MDRRC/Rc5ToXPressnet/Doc/pcb.JPG

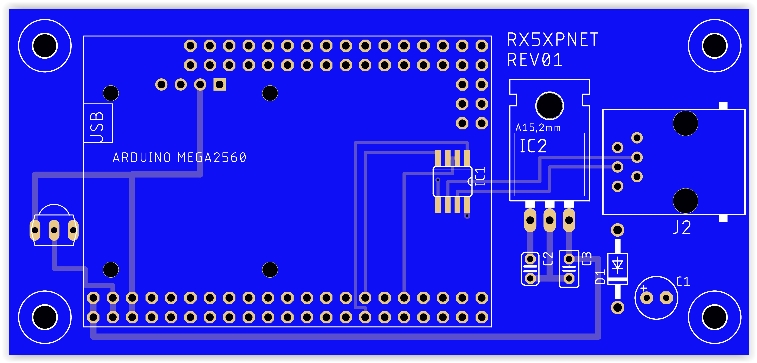
Doc/pcb.JPG
