MDRRC/Rc5ToXPressnet/Doc/rx5xpressnetcomponents.pdf

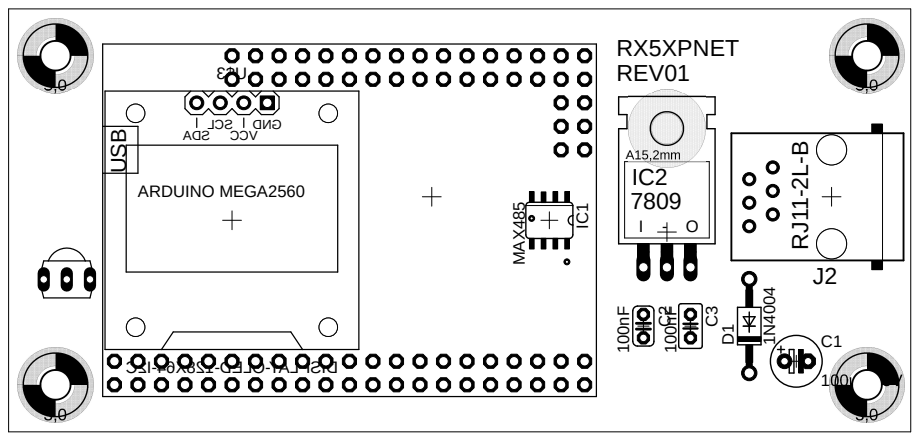
[picture p9: page 1]
ARDUINO MEGA2560 USB; RX5XPNET; REV01; C1 IC¹; 100uF/25V ¹N⁴⁰⁰⁴ MAX⁴⁸⁵
