MDRRC/Rc5ToXPressnet/Doc/rx5xpressnetschematic.pdf

D47 | D47 D46 | D46 D45 | D45 D44 | D44 D43 | D43 D42 | D42 D41 | D41 D40 | D40 D39 | D39 D38 | D38 D37 | D37 D36 | D36 D35 | D35 D34 | D34 D33 | D33 D32 | D32 A15 | A15 A14 | A14 A13 | A13 A12 | A12 A11 | A11 A10 | A10 A9 | A9 A8 | A8 A7 | A7 A6 | A6 A5 | A5 A4 | A4 A3 | A3 A2 | A2 A1 | A1 A0 | A0

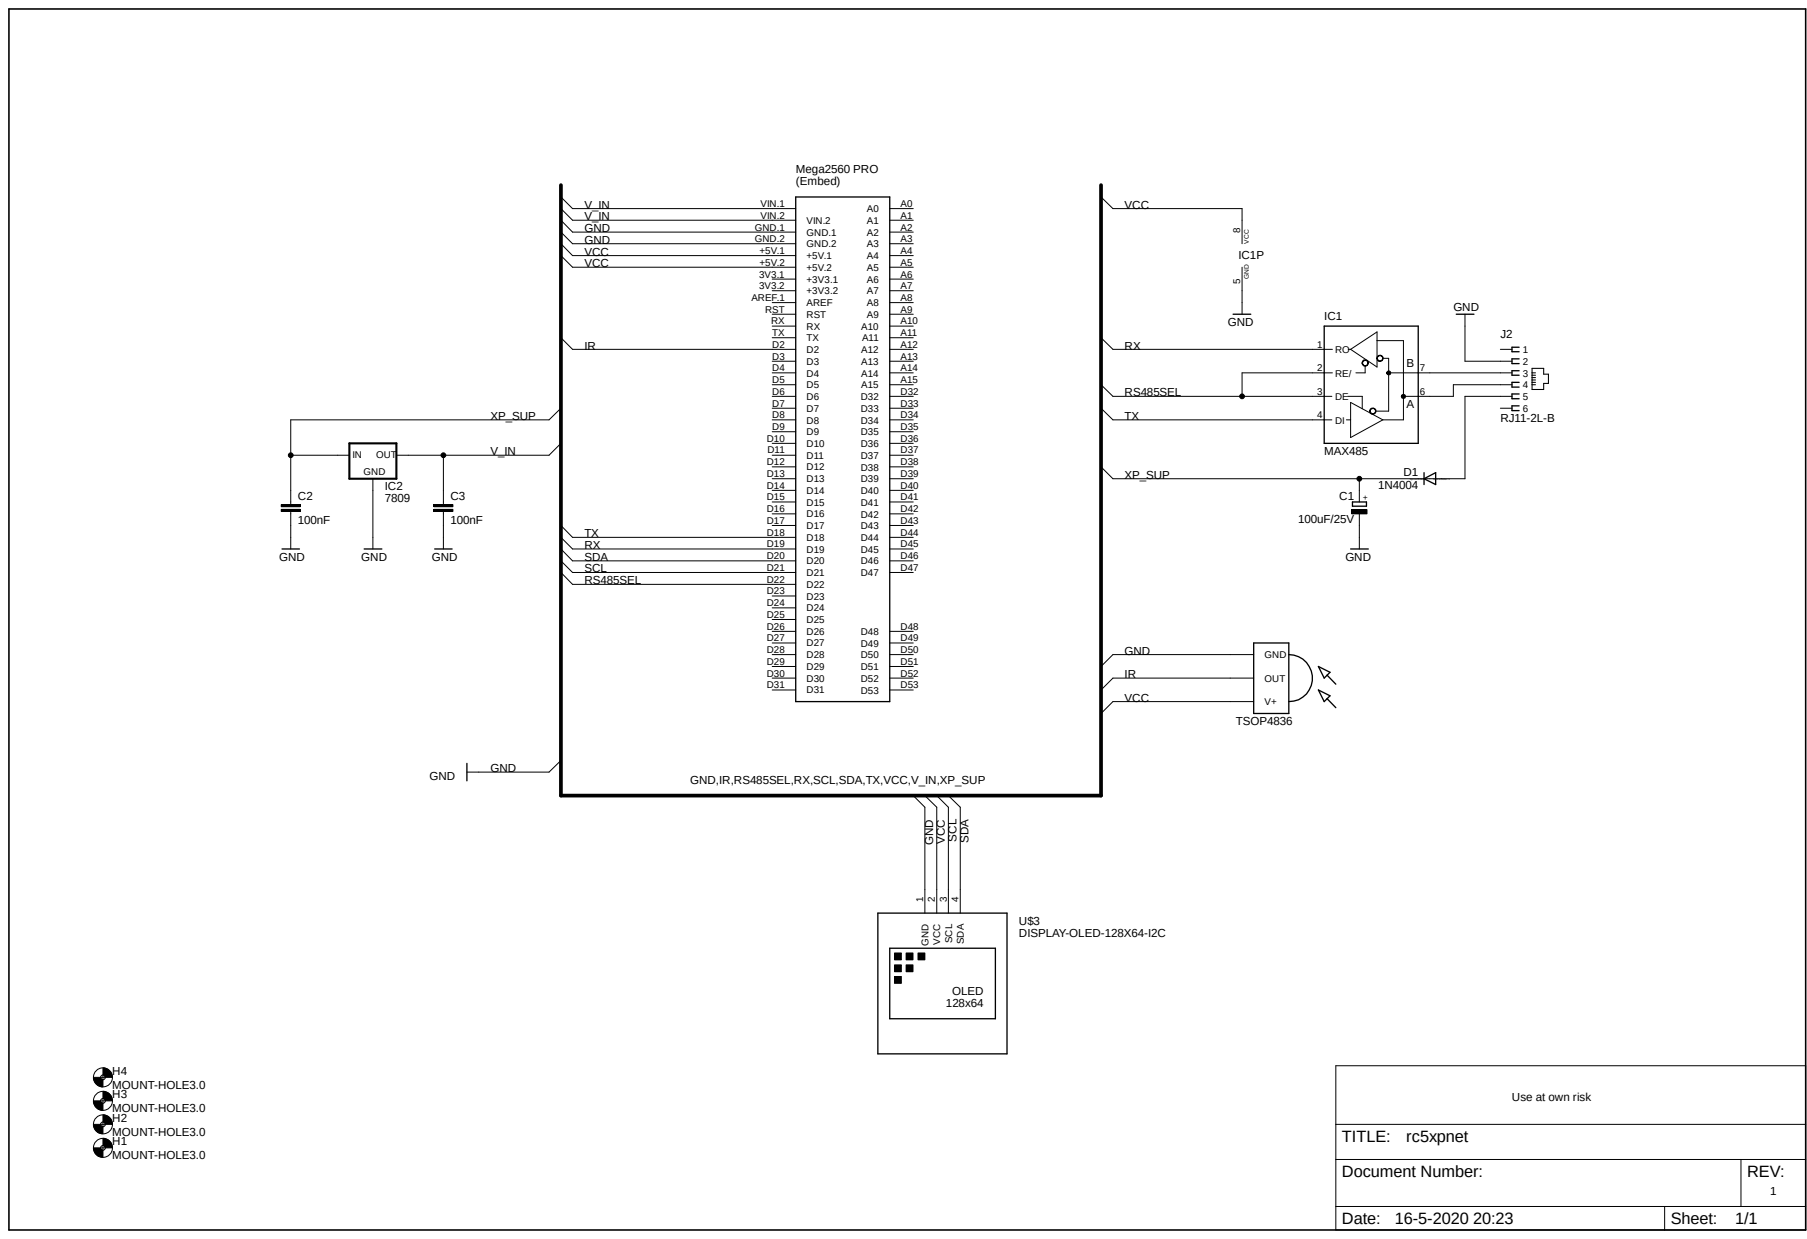
[picture p10: page 1]

GND,IR,RS485SEL,RX,SCL,SDA,TX,VCC,V_IN,XP_SUP VCC

Use at own risk

Document Number: | REV: 1

Date: 16-5-2020 20:23 | Sheet: 1/1
