MDRRC/Rc5ToXPressnet/(commit log)

2020-04-22 Store selected loc in EEPROM (and read it at power on).
2020-05-01 Added turnout handling. If turnout button pressed enter a address and hit a green or red turnout button. The address of the turnout is stored in EEPROM. When in power on (where the locomotive is cont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
2020-05-09 * Functions show F1 .. F10 (F10 as zero). * Added handling for button A..D, select loc, press A..D and the selected loc is stored. * When A..D is pressed and address valid store address in EEPROM. * 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
    [Rc5XpNet.ino]
2020-05-12 * Positions updated. * Status row text reduced some text length and clear yes/no of full row added. * When power on and a turnout is pressed the turnout number and direction are shown for 1.sec int h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
2020-05-12 Added PCB picture.
2020-05-16 * Added turnout symbol for indication of direction. * In turnout state F1 and F4 can be used to control an turnout without storage of the turnout number in EEPROM. * When a turnout number is entered 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
2020-05-16 Added schematic and component overview.
2020-05-16 Link to schematic pdf added.
2020-05-21 Added pictures of PCB.
2020-05-21 Pictures of PCB added.
2020-05-24 * Hard coded values replaced with static variables. * Double code in own routines. * Serial stuff removed.
    [Rc5XpNet.ino]
2020-06-02 Added Configuration state. * XPressNet address can be changed. * OFF button behavior can be changed. * The behavior of the +/- can be changed.
    The readme file
    * Added descriptions usage.
    * Updated info for required libraries.
    * Added how to program to board without building code by yourself, but needs the testes.......
    HEX file added for last item in upper description.
2020-07-11 Added transitionUpdateLocData. This routine request each 250 msec the actual loc data. So if the loc selected on Rx5XpNet is also controlled by another device the info of the loc will be updated if t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
2020-10-04 Correcting speed handling for 14 speed decoders.
    [Rc5XpNet.ino]
2020-10-05 For 14 speed decoders added conversion tables. Speed step 1 is emergency stop or direction change for MM (old). This step is "skipped" by using tables.
    [Rc5XpNet.ino]
2020-10-05 Sometimes getting loc data blocked. So StateGetLocInfo is updated, if initial locinof command is not handled correctly the transition transitionUpdateLocData updated the locinfo request.
    [Rc5XpNet.ino]
2020-10-06 Added Alternative Control option so speed can only be changed with +/- button and direction with left/right button. When option is false the direction will change when +/- buttons is pressed and spee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
    When changing direction the loc set speed will not be set to 0 anymore. Just change direction.
2020-10-07 Changes : * When direction is changed set speed to 0 and change direction. If a locomotive is if forward direction and right button is pressed or when a locomotive is in backward direction and left b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
    [Rc5XpNet.ino]
